lairdrt/miniblind-end-cap/reference/README.md

# Additional rail measurements

Record the metal bottom-rail cross-section, corner radii, internal opening of the original cap, insertion depth, and center boss engagement here.

The six original reference photos are in the original local project archive. They have not been uploaded to this public repository.
