lairdrt/miniblind-end-cap/exports/fit-gauge.stl

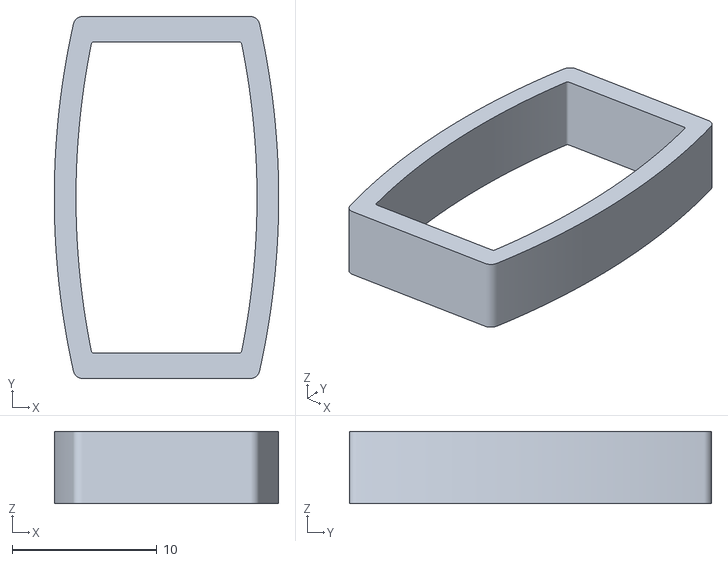
[picture p4: CAD file, 2026-10-24]
exports/fit-gauge.stl
15.5 x 25.0 x 5.00
