lairdrt/miniblind-end-cap/exports/end-cap.stl

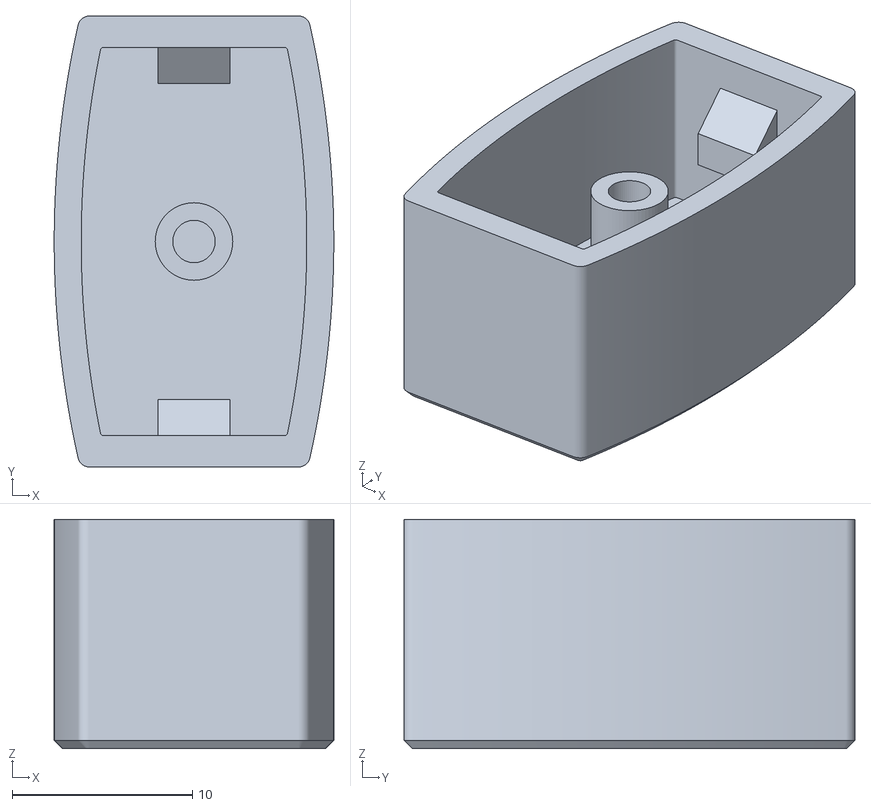
[picture p5: CAD file, 2026-10-24]
exports/end-cap.stl
15.5 x 25.0 x 12.7
