lairdrt/miniblind-end-cap/src/end-cap.scad

// Miniblind bottom-rail protective end cap
// Copyright (C) 2026. Released under GPL-3.0-or-later.
// X = width; Y = length; Z = depth. Z=0 is the closed end.
// v0.14: slide BOTH retention stubs +0.55mm toward open lip.
// Their tops are 2.0mm below the opening. Same X and Y locations,
// ramps, sizes, projection, outside, proven curved cavity and gauge.

/* [Configuration] */
mode = "final"; // [final,fit_gauge]

/* [Overall size (mm)] */
length = 25.0;
cap_depth = 12.7;

/* [Circular exterior (mm)] */
outer_width_center = 15.5;
outer_side_radius = 55.0; // Larger radius flattens bow, widening near the ends
corner_radius = 0.65;
face_chamfer = 0.45;

/* [Concentric interior arc (mm)] */
inside_length = 21.5;
inside_center_width = 12.5; // Measured target at center, independently adjustable
inside_corner_radius = 0.15;

/* [Strength (mm)] */
face = 2.6;

/* [Interior boss (mm)] */
include_boss = true;
boss_diameter = 4.3;
boss_height = 7.1;
bore_diameter = 2.35;
bore_depth = 5.0;

/* [Retention stubs (mm)] */
include_retention_stubs = true;
stub_width = 4.0;           // X: across the inner short end wall
stub_length = 5.0;          // Z: height along inner short end wall
stub_projection = 2.0;      // Y: maximum protrusion toward rail
stub_lead_ramp = 2.0;       // Z: slope encountered first during insertion
stub_trailing_ramp = 1.0;   // Z: slope toward the closed inner floor
stub_embed = 0.20;          // Hidden overlap into wall, not extra projection
stub_top_clearance = 2.0;   // Vertical gap below the open lip
stub_start_z = cap_depth - stub_top_clearance - stub_length;

/* [Gauge (mm)] */
gauge_depth = 5.0;

/* [Smoothness] */
inside_segments = 320;
$fn = 64;

assert(length > inside_length && inside_length > 0);
assert(outer_side_radius > length/2);
assert(outer_width_center > outer_width_ends && outer_width_ends > 0);
assert(cap_depth > face && face >= 1.2);
assert(inside_length > 0 && inside_length < length);
assert(inside_center_width > 0 && inside_center_width < outer_width_center);
assert(side_wall > 0.8);
assert(inside_side_radius > inside_length/2);
assert(inside_corner_radius >= 0 && inside_corner_radius < inside_center_width/4);
assert(corner_radius > 0 && corner_radius < outer_width_ends/4);
assert(face_chamfer >= 0 && face_chamfer < face);
assert(boss_diameter > bore_diameter && bore_depth > 0);
assert(boss_height > bore_depth && boss_height <= cap_depth-face);
assert(gauge_depth > 0 && gauge_depth <= cap_depth);
assert(stub_width > 0 && stub_width < 2*inside_half_width(inside_length/2));
assert(stub_projection > 0 && stub_projection < inside_length/2);
assert(stub_length > 0 && stub_length <= cap_depth-face);
assert(stub_lead_ramp > 0 && stub_trailing_ramp > 0);
assert(stub_lead_ramp + stub_trailing_ramp < stub_length);
assert(stub_embed > 0 && stub_embed < (length-inside_length)/2);
assert(stub_top_clearance >= 0);
assert(stub_start_z >= face && stub_start_z+stub_length <= cap_depth);

// Each exterior long side is one genuine circular arc (constant radius).
// End width (~12.62mm at R=55) derives from the circular radius.
// Outside maximum width at center stays 15.5mm; overall length stays 25mm.
outer_circle_cx = outer_width_center/2 - outer_side_radius;
outer_width_ends = 2*(outer_circle_cx + sqrt(outer_side_radius*outer_side_radius-pow(length/2,2)));
function outer_half_width(y) =
    outer_circle_cx + sqrt(outer_side_radius*outer_side_radius-y*y);

// Two truly concentric arcs, with constant normal separation on sides.
// Radial wall thickness = (15.5-12.5)/2 = 1.5mm.
// Interior radius = 55-1.5 = 53.5mm, concentric with exterior.
// Never apply an additional wall offset.
side_wall = (outer_width_center-inside_center_width)/2;
inside_side_radius = outer_side_radius-side_wall;
function inside_half_width(y) =
    outer_circle_cx + sqrt(inside_side_radius*inside_side_radius-y*y);

// Previous 10 mm end and 11.5 mm intermediate station constraints
// are removed. Center width, arc radius and length determine all points.
module outer_outline() {
    offset(r=corner_radius) offset(delta=-corner_radius)
        polygon(points=concat(
            [for (i=[0:inside_segments])
                let(y=-length/2+length*i/inside_segments)
                [outer_half_width(y),y]],
            [for (i=[inside_segments:-1:0])
                let(y=-length/2+length*i/inside_segments)
                [-outer_half_width(y),y]]
        ));
}

module cavity_outline() {
    offset(r=inside_corner_radius) offset(delta=-inside_corner_radius)
        polygon(points=concat(
            [for (i=[0:inside_segments])
                let(y=-inside_length/2+inside_length*i/inside_segments)
                [inside_half_width(y),y]],
            [for (i=[inside_segments:-1:0])
                let(y=-inside_length/2+inside_length*i/inside_segments)
                [-inside_half_width(y),y]]
        ));
}

module outer_body() {
    if (face_chamfer > 0) {
        hull() {
            linear_extrude(height=0.01)
                offset(delta=-face_chamfer) outer_outline();
            translate([0,0,face_chamfer])
                linear_extrude(height=0.01) outer_outline();
        }
        translate([0,0,face_chamfer])
            linear_extrude(height=cap_depth-face_chamfer) outer_outline();
    } else {
        linear_extrude(height=cap_depth) outer_outline();
    }
}

// Two centered grips on the INSIDE faces of the short Y-end walls.
// Side profile along Z is a trapezoid (/---\\), not a square block.
// As the cap slides on from the open mouth (high Z), the rail first
// meets the longer leading ramp, then the short raised plateau, then
// the shorter slope toward the closed floor (low Z).
// Horizontal center X=0 (centered extrusion). Both stubs shift vertically
// toward the opening with a 2mm lip gap: Z=5.70 .. 10.70mm.
// All polygon points retain their same relative offsets and geometry.
// The local polygon axes are (Y,Z); its extrusion axis maps to X.
module retention_stubs() {
    for (end_sign=[-1,1])
        multmatrix([[0,0,1,0],
                    [1,0,0,0],
                    [0,1,0,0],
                    [0,0,0,1]])
            linear_extrude(height=stub_width, center=true)
                polygon(points=[
                    [end_sign*(inside_length/2 + stub_embed), stub_start_z],
                    [end_sign*(inside_length/2), stub_start_z],
                    [end_sign*(inside_length/2 - stub_projection), stub_start_z+stub_trailing_ramp],
                    [end_sign*(inside_length/2 - stub_projection), stub_start_z+stub_length-stub_lead_ramp],
                    [end_sign*(inside_length/2), stub_start_z+stub_length],
                    [end_sign*(inside_length/2 + stub_embed), stub_start_z+stub_length]
                ]);
}

module full_cap() {
    difference() {
        union() {
            difference() {
                outer_body();
                translate([0,0,face])
                    linear_extrude(height=cap_depth-face+0.2)
                        cavity_outline();
            }
            if (include_boss)
                translate([0,0,face])
                    cylinder(h=boss_height, d=boss_diameter);
            if (include_retention_stubs)
                retention_stubs();
        }
        if (include_boss)
            translate([0,0,face+boss_height-bore_depth])
                cylinder(h=bore_depth+0.1, d=bore_diameter);
    }
}

module fit_gauge() {
    difference() {
        linear_extrude(height=gauge_depth) outer_outline();
        translate([0,0,-0.1])
            linear_extrude(height=gauge_depth+0.2) cavity_outline();
    }
}

if (mode == "fit_gauge") fit_gauge();
else full_cap();
