lairdrt/miniblind-end-cap/(list of files, cad)

Other CAD files:
exports/fit-gauge-geometry.3mf
exports/end-cap-geometry.3mf
