lairdrt/miniblind-end-cap/(commit log)

2026-10-23 Add parametric OpenSCAD full cap and fit gauge
    [end-cap.scad]
2026-10-23 Document prototype geometry, limitations, and GitHub export workflow
2026-10-23 Publish STL and 3MF exports from OpenSCAD when source changes
2026-10-23 Record measured 21x10mm rail and 21.3x10.3mm gauge target
2026-10-23 Document 21x10 rail measurements and first-gauge dimensions
2026-10-23 Parametrize 21.3x10.3mm measured-rail opening; trigger mesh exports
    [end-cap.scad]
2026-10-23 build: synchronize printable meshes [skip ci]
    [end-cap-geometry.3mf, end-cap.stl, fit-gauge-geometry.3mf, fit-gauge.stl]
2026-10-23 Fix regression: curve the interior to follow the end-cap exterior
    [end-cap.scad]
2026-10-23 Make curved interior-end taper independently adjustable and rebuild corrected meshes
    [end-cap.scad]
2026-10-23 Record failed gauge fit and single 0.5mm-per-side cavity correction
2026-10-23 Open curved cavity +1mm across full profile; reduce side walls 0.5mm each
    [end-cap.scad]
2026-10-24 Record 21.5mm three-station measured interior and offset compensation
2026-10-24 Use measured 21.5mm interior with symmetric 10/11.5/13mm curved widths
    [end-cap.scad]
2026-10-24 Replace nearly straight joined interior spline with single smooth exterior-tangent curve
    [end-cap.scad]
2026-10-24 Derive exterior from measured inner curve for parallel side walls
    [end-cap.scad]
2026-10-24 Use true constant-radius circles for outer sidewalls; preserve measured cavity
    [end-cap.scad]
2026-10-24 Use concentric interior arcs; 13mm center width is sole width constraint
    [end-cap.scad]
2026-10-24 Document inward 0.75mm wall thickening and fixed exterior
2026-10-24 Update README for 2mm inward sidewalls and unchanged exterior
2026-10-24 Increase curved wall thickness inward by 0.75mm per side; preserve outside
    [end-cap.scad]
2026-10-24 Record v0.10 0.25mm per-side rollback based on fit feedback
2026-10-24 Update README for 1.75mm curved walls and 12mm center opening
2026-10-24 Reduce curved side walls by 0.25mm each to 1.75mm; keep exterior fixed
    [end-cap.scad]
2026-10-24 Document v0.11 55mm concentric arcs and 12.5mm center opening
2026-10-24 Update README for 55mm side radius and 12.5mm center cavity
2026-10-24 Increase concentric arc radius to 55mm; target 12.5mm interior center
    [end-cap.scad]
2026-10-24 Add two centered 4x5x2mm trapezoidal short-end retention stubs
    [end-cap.scad]
2026-10-24 Center retention stubs vertically on inside short-end walls without changing fit
    [end-cap.scad]
2026-10-24 Record v0.14 0.55mm upward stub shift to 2mm below open lip
2026-10-24 Document two tabs shifted toward opening with 2mm lip clearance
2026-10-24 Slide both retention tabs 0.55mm toward opening; 2mm lip gap
    [end-cap.scad]
2026-10-24 build: synchronize printable meshes and OpenSCAD renders [skip ci]
    [end-cap-geometry.3mf, end-cap.stl, fit-gauge-geometry.3mf, fit-gauge.stl]
